emtenet/vt4/pcb/vt4.kicad_pcb

## KiCad design pcb/vt4.kicad_pcb (2026-01-26)

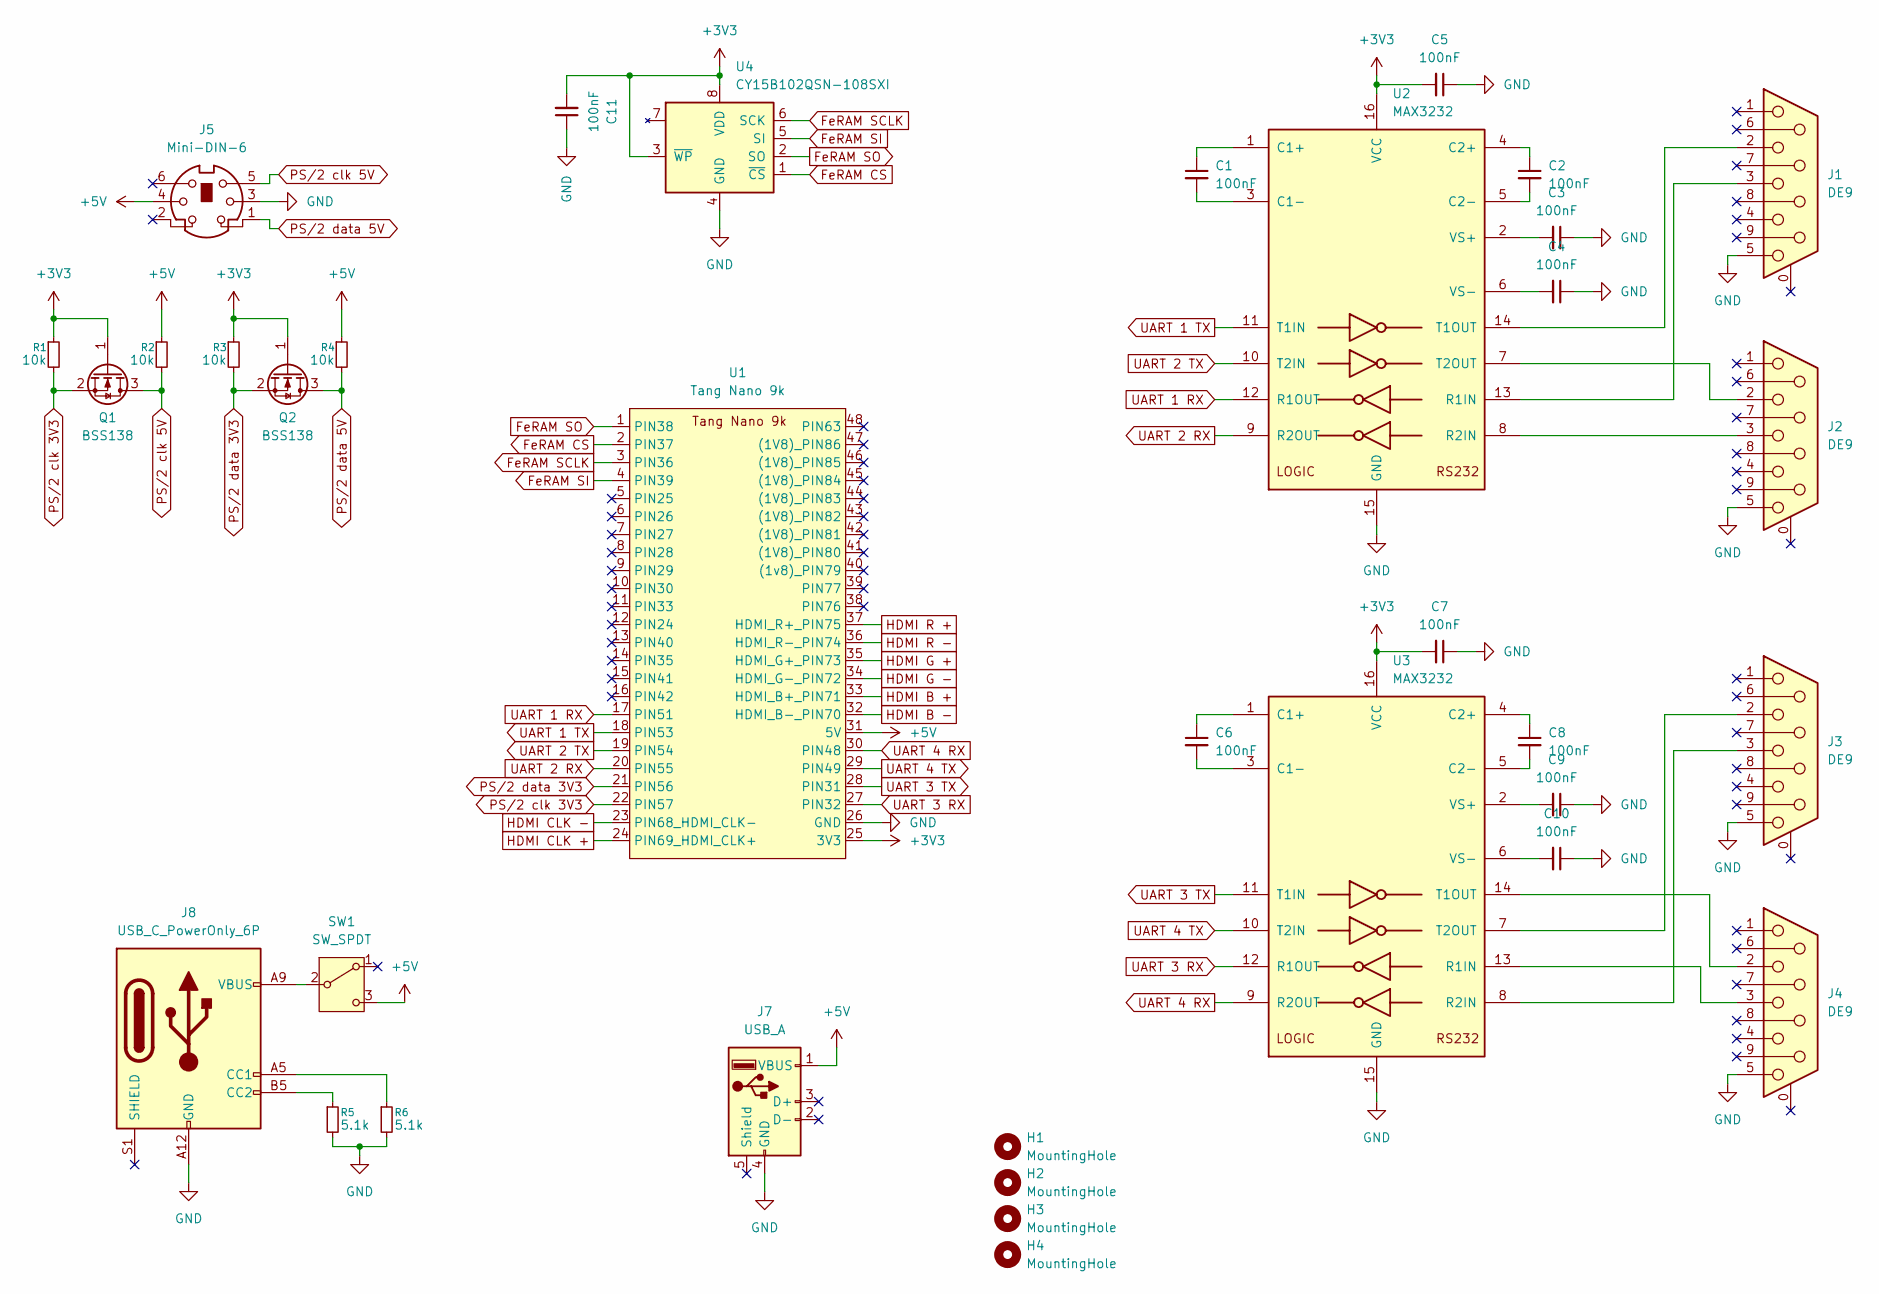
[picture p3: schematic vt4.kicad_sch]

Parts:
C1, C2, C3, C4, C5, C6, C7, C8, C9, C10, C11: 100nF; C_1206_3216Metric_Pad1.33x1.80mm_HandSolder
H1, H2, H3, H4: MountingHole; MountingHole_3.2mm_M3
J1, J2, J3, J4: DE9; DSUB_9_Pins_Female_Horizontal
J5: Mini-DIN-6; Mini_DIN_round_6_canned
J7: USB_A; USB_A_Stewart_SS-52100-001_Horizontal
J8: USB_C_PowerOnly_6P; USB_C_Receptacle_GCT_USB4125-xx-x-0190_6P_TopMnt_Horizontal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
Q1, Q2: BSS138; SOT-23_Handsoldering
R1, R2, R3, R4: 10k; R_1206_3216Metric_Pad1.30x1.75mm_HandSolder
R5, R6: 5.1k; R_1206_3216Metric_Pad1.30x1.75mm_HandSolder
SW1: SW_SPDT; SW_Lever_1P2T_NKK_GW12LxH
U1: Tang Nano 9k
U2, U3: MAX3232; SOIC-16_3.9x9.9mm_P1.27mm_Handsolder
U4: CY15B102QSN-108SXI; SOIC-8_5.3x5.3mm_P1.27mm_Handsolder

Connections:
+3V3: C5.2, C7.2, C11.2, Q1.1 (G), Q2.1 (G), R1.1, R3.1, U1.25 (3V3), U2.16 (VCC), U3.16 (VCC), U4.3 (~WP), U4.8 (VDD)
+5V: J5.4, J7.1 (VBUS), R2.1, R4.1, SW1.3 (C), U1.31 (5V)
FeRAM CS: U1.2 (PIN37), U4.1 (~CS)
FeRAM SCLK: U1.3 (PIN36), U4.6 (SCK)
FeRAM SI: U1.4 (PIN39), U4.5 (SI)
FeRAM SO: U1.1 (PIN38), U4.2 (SO)
GND: C3.1, C4.1, C5.1, C7.1, C9.1, C10.1, C11.1, J1.5, J2.5, J3.5, J4.5, J5.3, J7.4 (GND), J8.A12 (GND), J8.B12 (GND), R5.2, R6.2, U1.26 (GND), U2.15 (GND), U3.15 (GND), U4.4 (GND)
HDMI B +: U1.33 (HDMI_B+_PIN71)
HDMI B -: U1.32 (HDMI_B-_PIN70)
HDMI CLK +: U1.24 (PIN69_HDMI_CLK+)
HDMI CLK -: U1.23 (PIN68_HDMI_CLK-)
HDMI G +: U1.35 (HDMI_G+_PIN73)
HDMI G -: U1.34 (HDMI_G-_PIN72)
HDMI R +: U1.37 (HDMI_R+_PIN75)
HDMI R -: U1.36 (HDMI_R-_PIN74)
unnamed: J8.A5 (CC1), R6.1
unnamed: J8.B5 (CC2), R5.1
unnamed: J8.A9 (VBUS), J8.B9 (VBUS), SW1.2 (B)
unnamed: C1.1, U2.1 (C1+)
unnamed: C1.2, U2.3 (C1-)
unnamed: C2.1, U2.4 (C2+)
unnamed: C2.2, U2.5 (C2-)
unnamed: J1.3, U2.13 (R1IN)
unnamed: J2.3, U2.8 (R2IN)
unnamed: J1.2, U2.14 (T1OUT)
unnamed: J2.2, U2.7 (T2OUT)
unnamed: C3.2, U2.2 (VS+)
unnamed: C4.2, U2.6 (VS-)
unnamed: C6.1, U3.1 (C1+)
unnamed: C6.2, U3.3 (C1-)
unnamed: C8.1, U3.4 (C2+)
unnamed: C8.2, U3.5 (C2-)
unnamed: J4.3, U3.13 (R1IN)
unnamed: J3.3, U3.8 (R2IN)
unnamed: J4.2, U3.14 (T1OUT)
unnamed: J3.2, U3.7 (T2OUT)
unnamed: C9.2, U3.2 (VS+)
unnamed: C10.2, U3.6 (VS-)
PS/2 clk 3V3: Q1.2 (S), R1.2, U1.22 (PIN57)
PS/2 clk 5V: J5.5, Q1.3 (D), R2.2
PS/2 data 3V3: Q2.2 (S), R3.2, U1.21 (PIN56)
PS/2 data 5V: J5.1, Q2.3 (D), R4.2
UART 1 RX: U1.17 (PIN51), U2.12 (R1OUT)
UART 1 TX: U1.18 (PIN53), U2.11 (T1IN)
UART 2 RX: U1.20 (PIN55), U2.9 (R2OUT)
UART 2 TX: U1.19 (PIN54), U2.10 (T2IN)
UART 3 RX: U1.27 (PIN32), U3.12 (R1OUT)
UART 3 TX: U1.28 (PIN31), U3.11 (T1IN)
UART 4 RX: U1.30 (PIN48), U3.9 (R2OUT)
UART 4 TX: U1.29 (PIN49), U3.10 (T2IN)

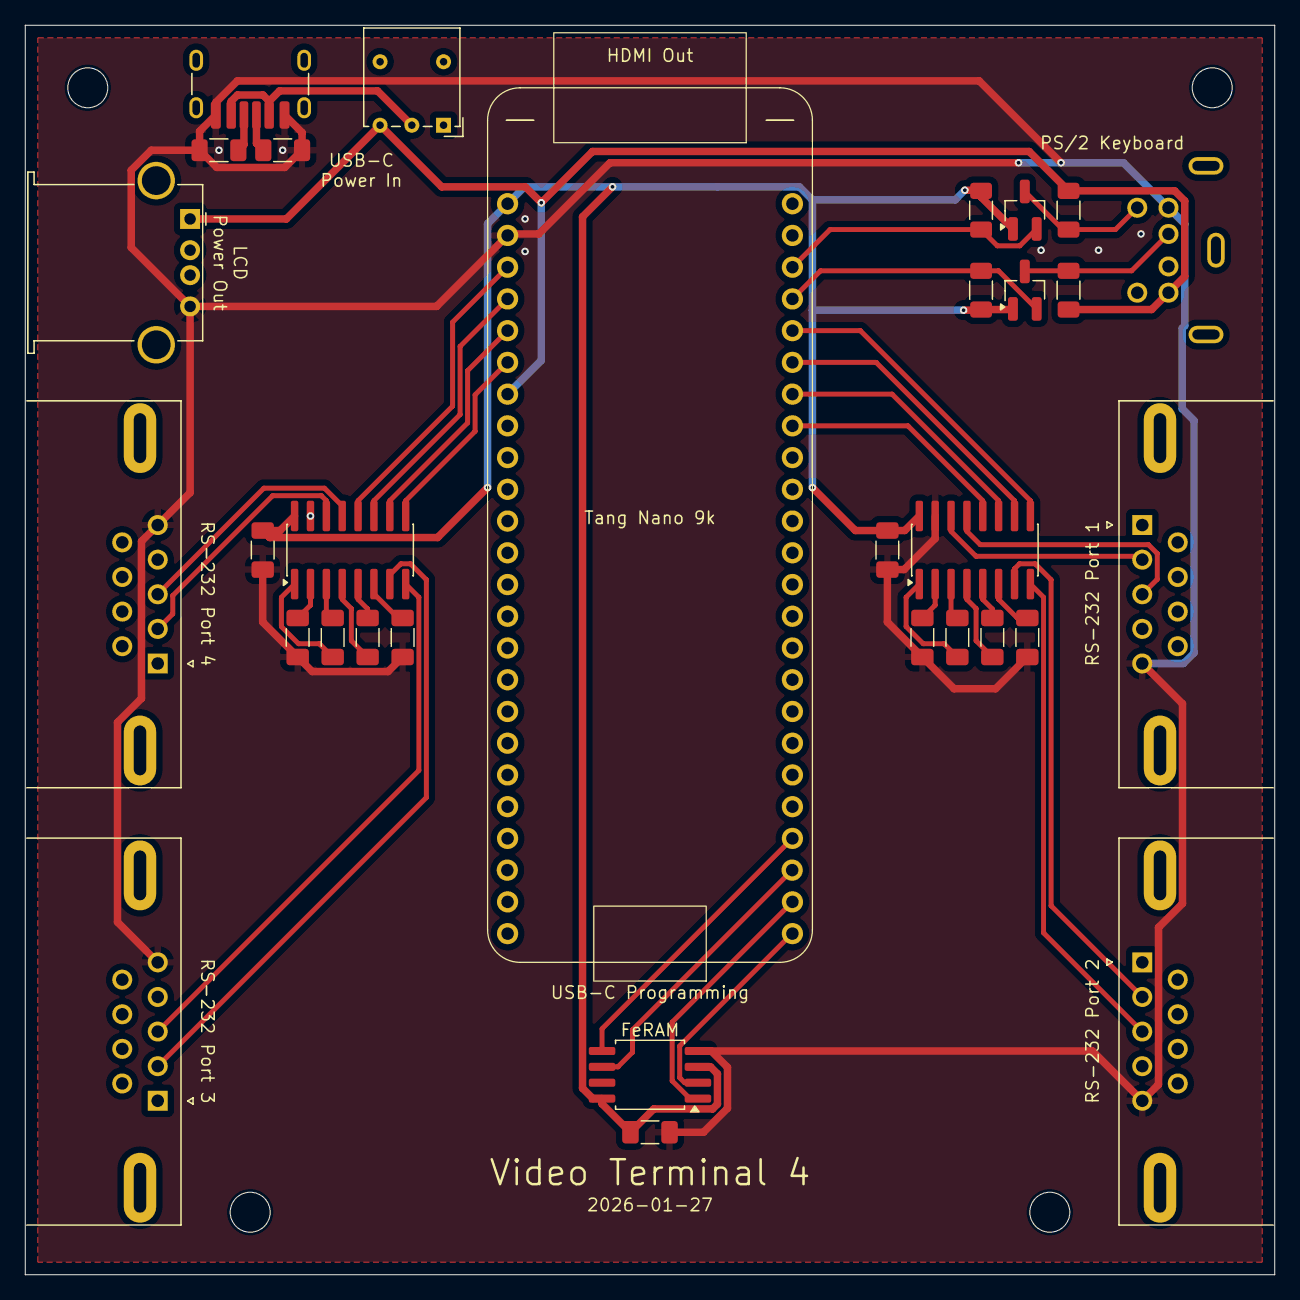
[picture p4: board vt4.kicad_pcb from above]

Board: 2 copper layers, 100.0 x 100.0 mm, 35 parts (0 on the bottom side), 42 nets.
