emtenet/vt4/fpga/src/hdmi.sv

`default_nettype none
`timescale 1ns / 1ps
module hdmi
(
    input   wire        clk,
    input   wire        clk_5x,
    input   wire        reset_low,

    input   wire [4:0]  top_row,

    input   wire [4:0]  cursor_row,
    input   wire [6:0]  cursor_col,

    output  wire        vram_valid,
    output  wire [4:0]  vram_row,
    output  wire [6:0]  vram_col,
    input   wire [7:0]  vram_byte,

    input   wire [1:0]  active_port,
    output  wire        v_sync,

    output  wire        hdmi_clk_n,
    output  wire        hdmi_clk_p,
    output  wire [2:0]  hdmi_data_n,
    output  wire [2:0]  hdmi_data_p
);

    wire        stage0_active;
    wire        stage0_h_sync;
    wire        stage0_v_sync;
    wire        stage0_h_start;
    wire        stage0_v_start;

    hdmi_timings hdmi_timings
    (
        .clk(clk),
        .reset_low(reset_low),

        .active(stage0_active),
        .h_sync(stage0_h_sync),
        .v_sync(stage0_v_sync),

        .h_start(stage0_h_start),
        .v_start(stage0_v_start)
    );

    always_comb begin
        v_sync = stage0_v_sync;
    end

    // STAGE 1 - 100 x 30 text display

    wire        stage1_active;
    wire        stage1_h_sync;
    wire        stage1_v_sync;
    wire [4:0]  stage1_row;
    wire [4:0]  stage1_row_pixel;
    wire        stage1_border;
    wire [6:0]  stage1_col;
    wire        stage1_col_start;
    wire [3:0]  stage1_col_pixel;

    hdmi_text_mode hdmi_text_mode
    (
        .clk(clk),

        .in_active(stage0_active),
        .in_h_sync(stage0_h_sync),
        .in_v_sync(stage0_v_sync),
        .in_h_start(stage0_h_start),
        .in_v_start(stage0_v_start),

        .top_row(top_row),

        .out_active(stage1_active),
        .out_h_sync(stage1_h_sync),
        .out_v_sync(stage1_v_sync),
        .out_row(stage1_row),
        .out_row_pixel(stage1_row_pixel),
        .out_border(stage1_border),
        .out_col(stage1_col),
        .out_col_start(stage1_col_start),
        .out_col_pixel(stage1_col_pixel)
    );

    // STAGE 2 - read char from VRAM at row,col

    reg         stage2_active;
    reg         stage2_h_sync;
    reg         stage2_v_sync;
    reg [4:0]   stage2_row_pixel;
    reg         stage2_border;
    reg         stage2_col_start;
    wire [7:0]  stage2_byte;
    reg         stage2_invert;

    always_comb begin
        vram_valid = stage1_col_start;
        vram_row = stage1_row;
        vram_col = stage1_col;
        stage2_byte = vram_byte;
    end

    always_ff @(posedge clk) begin
        stage2_active <= stage1_active;
        stage2_h_sync <= stage1_h_sync;
        stage2_v_sync <= stage1_v_sync;
        stage2_row_pixel <= stage1_row_pixel;
        stage2_border <= stage1_border;
        stage2_col_start <= stage1_col_start;
        stage2_invert = NO;
        if (stage1_row == cursor_row && stage1_col == cursor_col) begin
            stage2_invert = YES;
        end
    end

    // get horizontal pixels for char

    reg         stage3_h_sync;
    reg         stage3_v_sync;
    reg         stage3_active;
    reg         stage3_border;
    reg         stage3_col_start;
    reg         stage3_invert;
    wire [9:0]  stage3_pixels;

    always_ff @(posedge clk) begin
        stage3_active <= stage2_active;
        stage3_h_sync <= stage2_h_sync;
        stage3_v_sync <= stage2_v_sync;
        stage3_border <= stage2_border;
        stage3_col_start <= stage2_col_start;
        stage3_invert <= stage2_invert;
    end

    char_rom char_rom
    (
        .clk(clk),
        .ce(stage2_col_start),
        .char(stage2_byte),
        .row(stage2_row_pixel),
        .q(stage3_pixels)
    );

    // STAGE 4 - shift out char pixels

    reg         stage4_h_sync;
    reg         stage4_v_sync;
    reg         stage4_active;
    reg         stage4_border;
    reg [9:0]   stage4_pixels;
    wire        stage4_pixel;
    wire [23:0] stage4_rgb;

    always_ff @(posedge clk) begin
        stage4_active <= stage3_active;
        stage4_h_sync <= stage3_h_sync;
        stage4_v_sync <= stage3_v_sync;
        stage4_border <= stage3_border;

        // shift through char pixels
        if (stage3_col_start) begin
            if (stage3_invert == YES) begin
                stage4_pixels <= ~stage3_pixels;
            end else begin
                stage4_pixels <= stage3_pixels;
            end
        end else begin
            stage4_pixels <= {stage4_pixels[8:0], 1'b0};
        end
    end

    wire [23:0]  border_rgb;

    always_comb begin
        case (active_port)
            2'h0: border_rgb = 24'b110000000000000000000000;
            2'h1: border_rgb = 24'b000000001100000000000000;
            2'h2: border_rgb = 24'b000000000000000011000000;
            2'h3: border_rgb = 24'b110000001100000011000000;
        endcase
    end

    always_comb begin
        stage4_pixel = stage4_pixels[9];
        if (stage4_border == YES) begin
            stage4_rgb = border_rgb;
        end else begin
            stage4_rgb = {3{stage4_pixel,7'b0}};
        end
    end

    hdmi_encode hdmi_encode (
        .clk(clk),
        .clk_5x(clk_5x),
        .reset_low(reset_low),

        .active(stage4_active),
        .h_sync(stage4_h_sync),
        .v_sync(stage4_v_sync),
        .rgb(stage4_rgb),

        .hdmi_clk_n(hdmi_clk_n),
        .hdmi_clk_p(hdmi_clk_p),
        .hdmi_data_n(hdmi_data_n),
        .hdmi_data_p(hdmi_data_p)
    );

endmodule
