emtenet/vt4/fpga/src/hdmi_tmds.sv

/*
 *  SVO - Simple Video Out FPGA Core
 *
 *  Copyright (C) 2014  Clifford Wolf <clifford@clifford.at>
 *
 *  Permission to use, copy, modify, and/or distribute this software for any
 *  purpose with or without fee is hereby granted, provided that the above
 *  copyright notice and this permission notice appear in all copies.
 *
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
 */
`default_nettype none
`timescale 1ns / 1ps

module hdmi_tmds (
	input wire 			clk,
	input wire			reset_low,

	input wire			active,
	input wire			h_sync,
	input wire			v_sync,
	input wire [7:0]	data_in,

	output reg [9:0]	data_out
);


	// Variable and function names below match the spec names for
	// better readability when comparing to spec encoder flow diagram.
	wire [7:0] D = data_in;

	function [3:0] N1;
		// Count the number of '1' bits.
		input [7:0] bits;
		integer i;
		begin
			N1 = 0;
			for (i = 0; i < 8; i = i+1)
				N1 = N1 + bits[i];
		end
	endfunction

	function [3:0] N0;
		// Count the number of '0' bits.
		input [7:0] bits;
		integer i;
		begin
			N0 = 0;
			for (i = 0; i < 8; i = i+1)
				N0 = N0 + !bits[i];
		end
	endfunction

	reg [9:0] data_buf, q_out, q_out_next;
	reg [3:0] N0_q_m, N1_q_m;
	reg signed [7:0] cnt, cnt_next, cnt_tmp;
	reg [8:0] q_m;

	always @(posedge clk) begin
		if (reset_low == 1'b0) begin
			cnt   <= 0; // Data stream disparity count used for DC balance
			q_out <= 0;
		end else if (active == 1'b0) begin
			cnt   <= 0; // Reset disaprity when not actively displaying
			case ({v_sync, h_sync}) // See spec section "Control Period Coding"
				2'b00: q_out <= 10'b1101010100;
				2'b01: q_out <= 10'b0010101011;
				2'b10: q_out <= 10'b0101010100;
				2'b11: q_out <= 10'b1010101011;
			endcase
		end else begin
			// See spec flow diagram in section "Video Data Coding"
			if ((N1(D) > 4) | ((N1(D) == 4) & (D[0] == 0))) begin
				q_m[0] =           D[0];
				q_m[1] = q_m[0] ^~ D[1];
				q_m[2] = q_m[1] ^~ D[2];
				q_m[3] = q_m[2] ^~ D[3];
				q_m[4] = q_m[3] ^~ D[4];
				q_m[5] = q_m[4] ^~ D[5];
				q_m[6] = q_m[5] ^~ D[6];
				q_m[7] = q_m[6] ^~ D[7];
				q_m[8] = 1'b0;
			end
			else begin
				q_m[0] =          D[0];
				q_m[1] = q_m[0] ^ D[1];
				q_m[2] = q_m[1] ^ D[2];
				q_m[3] = q_m[2] ^ D[3];
				q_m[4] = q_m[3] ^ D[4];
				q_m[5] = q_m[4] ^ D[5];
				q_m[6] = q_m[5] ^ D[6];
				q_m[7] = q_m[6] ^ D[7];
				q_m[8] = 1'b1;
			end

			N0_q_m = N0(q_m[7:0]);
			N1_q_m = N1(q_m[7:0]);

			if ((cnt == 0) | (N1_q_m == N0_q_m)) begin
				q_out_next[9]    = ~q_m[8];
				q_out_next[8]    =  q_m[8];
				q_out_next[7:0]  = (q_m[8] ? q_m[7:0] : ~q_m[7:0]);
				if (q_m[8] == 0) begin
					cnt_next = cnt + (N0_q_m - N1_q_m);
				end else begin
					cnt_next = cnt + (N1_q_m - N0_q_m);
				end
			end else if (((cnt > 0) & (N1_q_m > N0_q_m)) | (((cnt < 0) & (N0_q_m > N1_q_m)))) begin
				q_out_next[9]    =  1'b1;
				q_out_next[8]    =  q_m[8];
				q_out_next[7:0]  = ~q_m[7:0];
				cnt_tmp          = cnt + (N0_q_m - N1_q_m);
				if (q_m[8]) begin
					cnt_next = cnt_tmp + 2'h2;
				end else begin
					cnt_next = cnt_tmp;
				end
			end else begin
				q_out_next[9]    =  1'b0;
				q_out_next[8]    =  q_m[8];
				q_out_next[7:0]  =  q_m[7:0];
				cnt_tmp          = cnt + (N1_q_m - N0_q_m);
				if (q_m[8]) begin
					cnt_next = cnt_tmp;
				end else begin
					cnt_next = cnt_tmp - 2'h2;
				end
			end
			cnt   <= cnt_next;
			q_out <= q_out_next;
		end

		// add two additional ff stages, give synthesis retime some slack to work with
		data_buf <= q_out;
		data_out <= data_buf;
	end
endmodule
