emtenet/vt4/fpga/src/button_handshake.sv

`default_nettype none
`timescale 1ns / 1ps
module button_handshake
(
    input   wire        clk,
    input   wire        reset_low,

    input   wire        button,

    input   wire        ready,
    output  reg 		valid
);

    wire debounced;

    debouncer
    #(
        .CYCLES(255)
    )
    for_button
    (
        .clk(clk),
        .reset_low(reset_low),

        .bit_in(button),
        .bit_out(debounced)
    );

    wire pos_edge;
    wire neg_edge;
    wire any_edge;

    edge_detector on_debounced
    (
        .clk(clk),
        .reset_low(reset_low),

        .level(debounced),

        .pos_edge(pos_edge),
        .neg_edge(neg_edge),
        .any_edge(any_edge)
    );

    initial begin
        valid = NO;
    end

    always @(posedge clk) begin
        // handshake complete
        if (ready == YES) begin
            valid <= NO;
        end

        // button pressed
        if (neg_edge == YES) begin
            valid <= YES;
        end
    end

endmodule
