emtenet/vt4/fpga/src/edge_detector.sv

`default_nettype none
`timescale 1ns / 1ps
module edge_detector
(
    input   wire        clk,
    input   wire        reset_low,

    input   wire        level,

    output  reg         pos_edge,
    output  reg         neg_edge,
    output  reg         any_edge
);

    reg previous = LOW;

    always @(posedge clk) begin
        if (reset_low == LOW) begin
            previous <= LOW;
        end else begin
            previous <= level;
        end
    end

    always @(*) begin
        pos_edge = (level == HIGH) && (previous == LOW);
        neg_edge = (level == LOW) && (previous == HIGH);
        any_edge = pos_edge | neg_edge;
    end

endmodule
