emtenet/vt4/fpga/src/types.sv

`default_nettype none
`timescale 1ns / 1ps
package types;
    localparam YES = 1'b1;
    localparam NO = 1'b0;

    localparam HIGH = 1'b1;
    localparam LOW = 1'b0;

    localparam ALWAYS = 1'b1;
    localparam NEVER = 1'b0;
endpackage

import types::*;
