emtenet/vt4/(commit log)

2025-11-23 Highlight R24 on PCB
2025-11-23 Test the LCD backlight enable/disable wiring after R24 has been shorted
2025-12-30 Add a PS/2 receiver
    Show low 6 bits of PS/2 data bytes on LED
2026-01-01 Show PS/2 errors on LED
2026-01-02 Refactor PS/2 module
    * Rename port interface to scan_code/_ready/_valid
    * Refactor state/frame state loop
    * Add a watchdog timer (now hot plug of keyboard works)
2026-01-04 Switch to SystemVerilog
2026-01-04 Forgot in switch to SystemVerilog
2026-01-06 CAPS LOCK & NUM LOCK now work! They toggle the LEDs!
2026-01-07 Set LEDs after PS/2 self test
2026-01-08 Put PS/2 pin in/out/oe & debouncing into ps2_physical module
2026-01-09 Add uart modules with tests
2026-01-09 PS/2 and UART tests share common simulation_base.h
2026-01-09 Connect up UART to PS/2 and HDMI uart RX -> HDMI PS/2 -> uart TX
2026-01-12 Fix bug where characters where displayed once column to the right. Remove REG on stage2_byte which was registering the previous character.
    [hdmi.sv]
2026-01-12 Connect UART pins to external MAX3232 chip instead of the one tunnelled through the USB programming header
2026-01-14 First draft of PCB
    [vt4.kicad_pcb, vt4.kicad_sch]
2026-01-14 Add name and order pcb
    [vt4.kicad_pcb]
2026-01-14 PCB fail - connected UART 1 up to HDMI clk pins
    [vt4.kicad_pcb, vt4.kicad_sch]
2026-01-23 Update pins (and use UART #4) to test on PCB
2026-01-23 Update PCB based on what was learnt soldering & testing
    [vt4.kicad_pcb, vt4.kicad_sch]
2026-01-26 Send PCB of for manufacturing * switch FeRAM to 3V3 pins (and supply) * update FPGA pin numbers to match
    [vt4.kicad_pcb, vt4.kicad_sch]
2026-02-13 Test out a coloured border as a way of indicating the active UART 1..4
2026-02-13 Fix up pins for UART 3 & 4
    [vt4.kicad_sch]
2026-02-21 Still got issues after improving the soldering
2026-03-01 Move UART module into VT module
2026-03-01 Switch between the 4 ports with Alt-F1 .. Alt-F4
